Jisaye/GaN-Design/Design_path.md

# 设计思路

先进行开环的测试，后根据需要加入ADC转接板（SMA连接）进行闭环测试

开环测试思路

# 结构设计

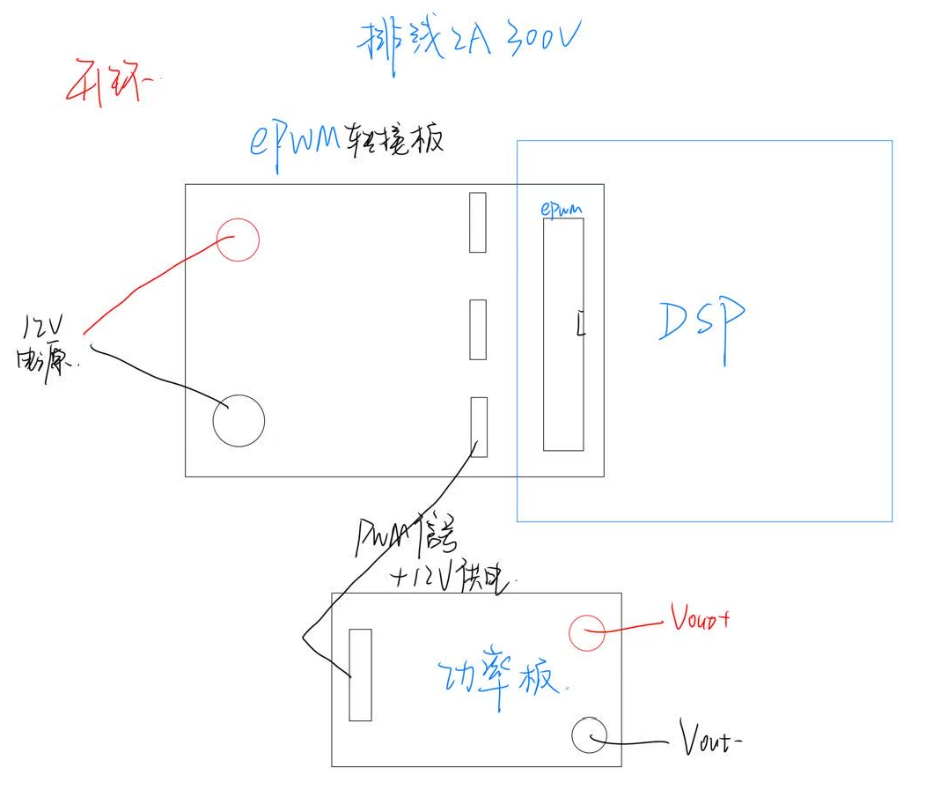
[picture p8: attachments/image-20251018164756367.png]


所以就分为EPWM转接板和主功率板两部分硬件进行设计

主功率板：

1.供电模块 2.缓冲电路 3.隔离稳压电路 4.栅极驱动电路 5.主功率桥

EPWM转接板（4层板，电源信号隔离）：

1.12V供电端口 2.三个排针连接主功率板 3.20pin排母连接EPWM模块

# 原理图设计

## 供电电路设计

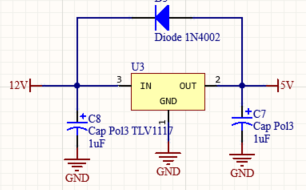
[picture p9: attachments/image-20251024210929914.png]


主要采用TLV1117芯片进行稳压，输入端口通过排插输入12V的直流电压，经过稳压后得到5V电压，用于施密特触发器芯片供电以及栅极驱动芯片的供电，设计二极管保护电路，防止12V与5V电源短接。

## 缓冲电路设计

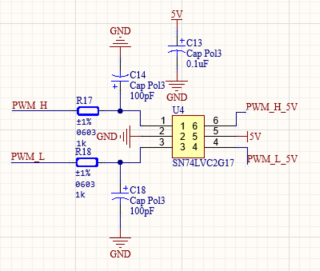
[picture p10: attachments/image-20251024211805117.png]


主要采用SN74LVC2G17 双施密特触发缓冲器，对高低端驱动的PWM进行缓冲与整形，提升信号的驱动能力和抗干扰能力，使得PWM能输出更稳定的5V电平信号，确保PWM信号在传输和处理过程中保持良好的波形质量。

## 隔离稳压电路设计

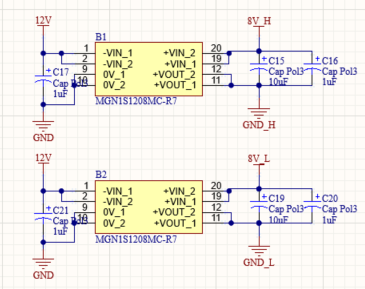
[picture p11: attachments/image-20251024212335833.png]


主要采用MGNS11208M (R-7) 芯片，用于将12V的输入电压转换为8V的输出，分高低两侧，这是为了给GaN增强型Mos的栅极驱动电路**提供单独的上拉**，需要8V的独立电源，故需要对8V电源进行隔离，分高低两侧。

## 栅极驱动电路设计

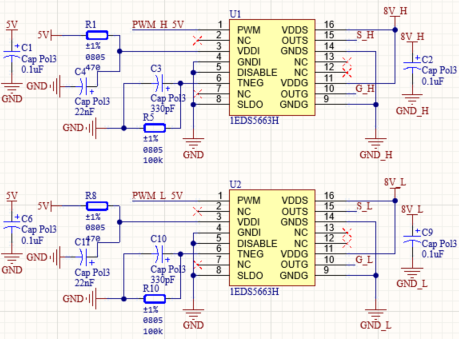
[picture p12: attachments/image-20251024213008706.png]


主要采用1EDS5663H栅极驱动芯片，用于驱动功率桥，实现对PWM信号的功率放大，输出高驱动能力的控制信号。特别注意这里的VDDI引脚输入位5V经过470Ω的电阻分压输入，根据数据手册分析，VDDI引脚通常输入3.3V电压，这里可能是考虑到5VPWM信号的注入（PWM/DISABLE引脚允许最大输入电压为6.5V）和G/S双端输出的高功率PWM信号，3.3V的供电不足以驱动。

OUTG连接GaN MOS栅极，OUTS连接GaN MOS源极，PWM引脚选通OUTG/OUTS。

## 主功率桥设计

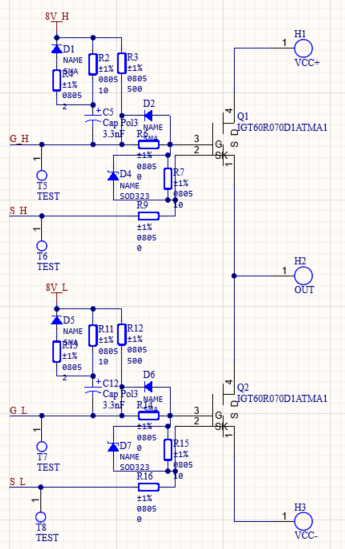
[picture p13: attachments/image-20251024213826315.png]


主要采用IGT60R070D1ATMA1增强型Mos作为主功率桥，实现对大功率负载的开关控制，通过 G_H、S_H 和 G_L、S_L 输入的驱动信号，控制 Q1、Q2 的导通与关断，从而在 OUT 端实现功率输出。IGT60R070D1ATMA1 是高压功率 MOS 管，用于承载大电流、高电压的功率传输。该增强型Mos必须运行在5~6.5V的栅极驱动下。

由二极管（D1-D4、D5、D6）、电阻（R2-R4、R7、R11-R13、R16 等）、电容（C2、C12）组成，起到信号驱动、电压钳位、过压保护等作用，确保 MOS 管稳定可靠工作。注意设计齐纳二极管对GS端进行稳压，但是也要尽量避免齐纳二极管产生的振铃现象导致驱动Mos的电压过冲而击穿。为减小齐纳二极管产生的振铃或减小环路电感请看Readme手册。

## RC吸收电路设计

主要避免电压过冲击穿Mos管。降压式缓冲电路

RC snubber通常放置在开关节点和GND之间

当时，振铃电压的振幅最低。

同时Csnub越大，同样的阻尼电阻对振铃抑制效果越好，但是达到一定程度大小以后，电容的增加给振铃抑制的效果并不显著，并且Csnub越大，对应电路的损耗会越大，效率会越差。

损耗主要包括两个方面：1.snubber电阻上的损耗，正比于电容容值。2.Mos开关损耗

因此需要在控制功耗和抑制振铃之间找到较好的平衡。



Vsw_peak为振铃峰值，fsw为开关频率

**实用快捷的snubber设计方法：**

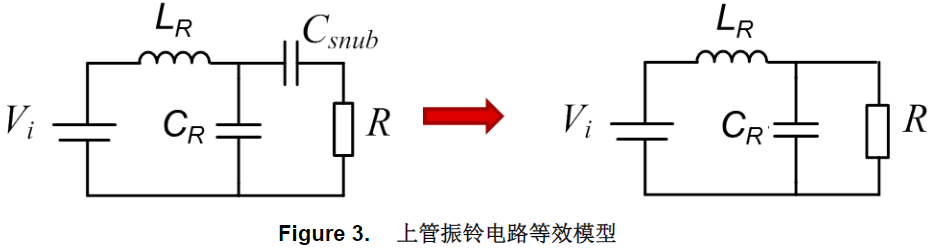
[picture p14: attachments/image-20251025142340731.png]
第一步：确定LR和CR

测量初始振铃频率：



在snubber要放置的位置上，放置一个Cadd，也就是在R的位置放一个电容，可以测得新的振铃频率表达式：



解得：

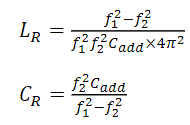
[picture p15: attachments/image-20251025142719294.png]


第二步：选取合适的R值，使得R值近似于

注意电阻的封装要考虑散热，使得电阻功率等级大于电阻上的损耗，根据电阻损耗表达式进行计算。

第三步：选择合适的电容值Csnub



以该式为起点，根据损耗情况和振幅抑制效果，进行进一步的调整——增大电容抑制振幅，减小电容提高效率。

下面是几种设计样例：

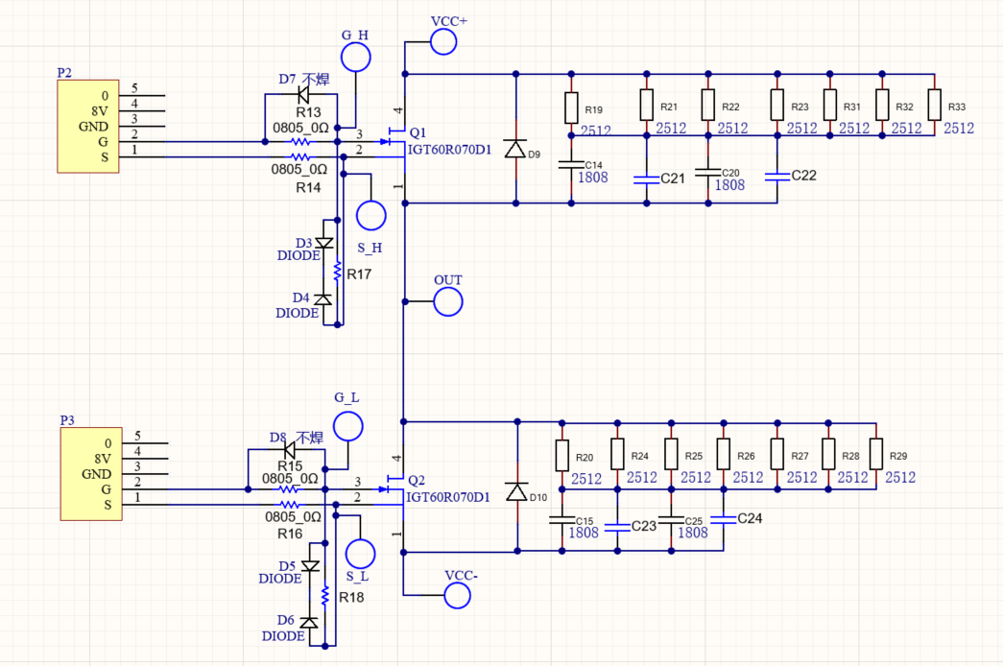
[picture p16: attachments/image-20251024220959552.png]


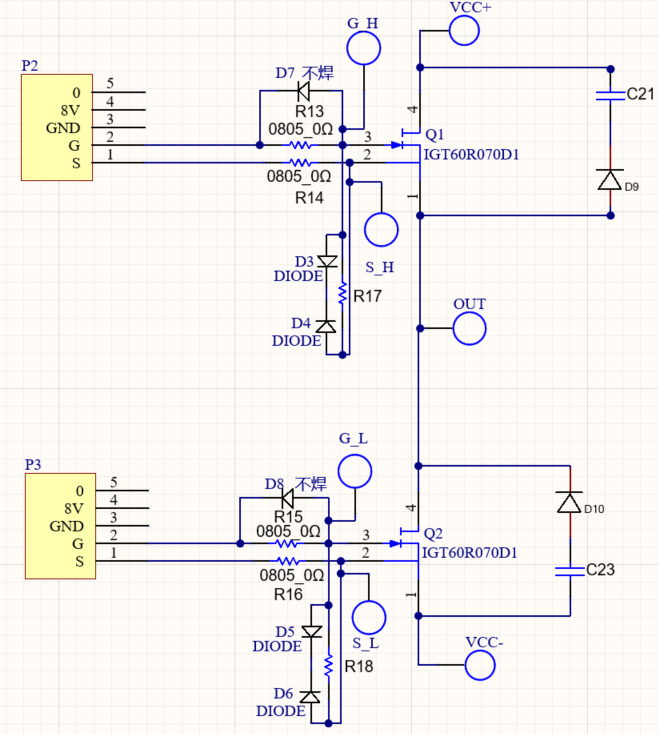
[picture p17: attachments/image-20251024221012875.png]


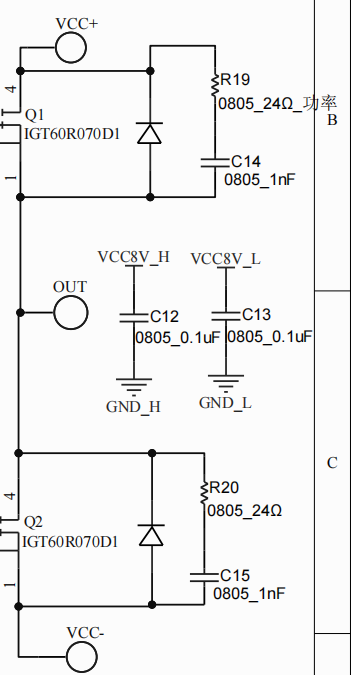
[picture p18: attachments/image-20251024221059903.png]


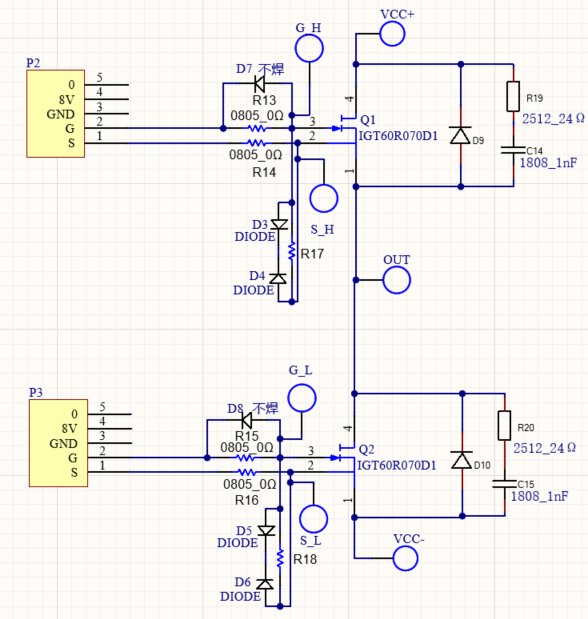
[picture p19: attachments/image-20251024221135009.png]


# PCB设计

单个半桥驱动模块：

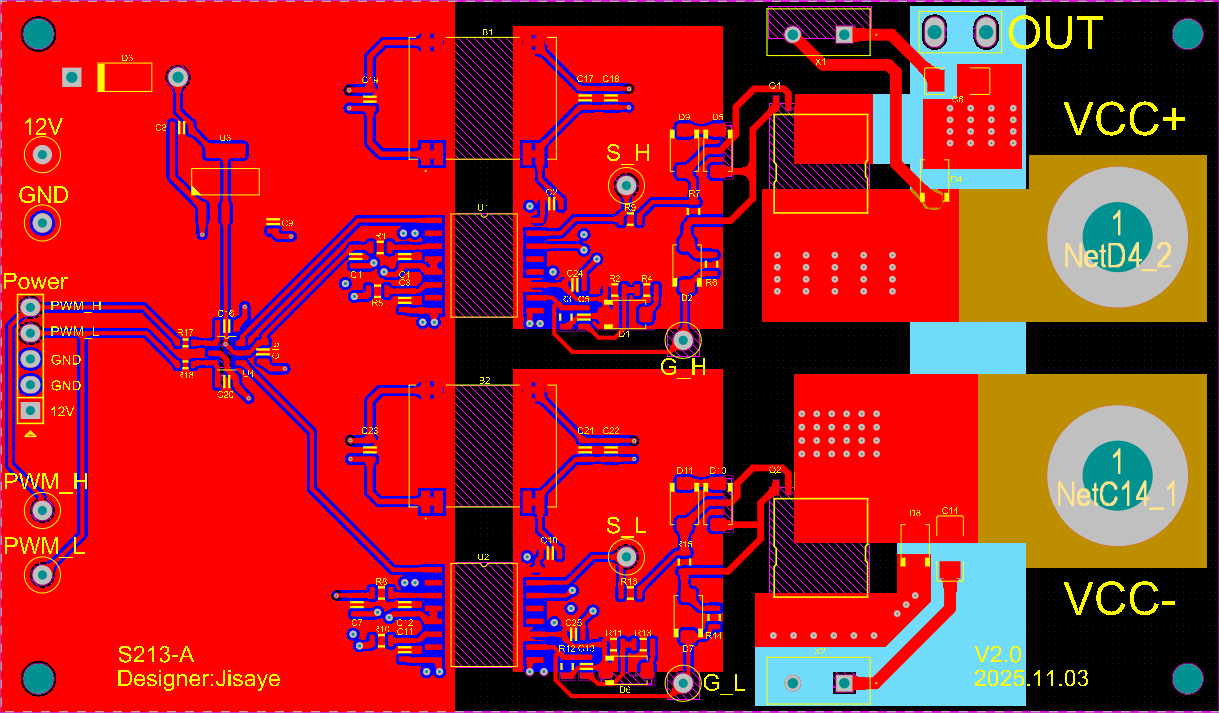
[picture p20: attachments/image-20251115161653602.png]


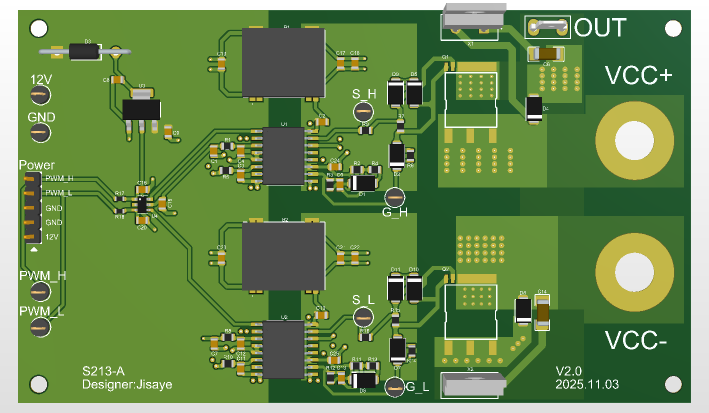
[picture p21: attachments/92a81938bc1906c612e0f3bcebc02985.png]
92a81938bc1906c612e0f3bcebc02985


扩展板：

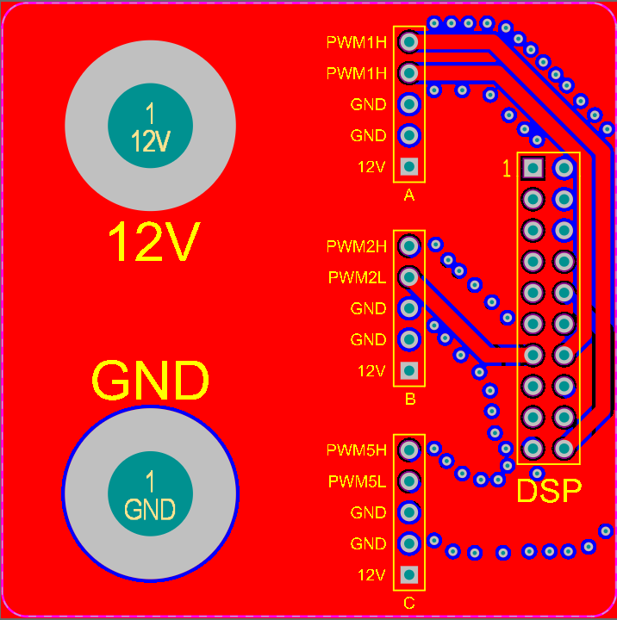
[picture p22: attachments/image-20251115161814362.png]


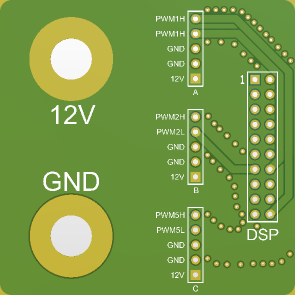
[picture p23: attachments/Adapter_board.png]
Adapter_board


注意铺铜和过孔扇出问题（散热）：

1.在电路板另一面放置一个铜平面也能让热阻降低10%~20%，这个“背面的”铜平面甚至不必有电气连接，或只是普通的地平面。

2.导热过孔（孔洞直径为0.3~0.33mm），给定面积内，过孔间距（即圆心之间的距离）一般为1~1.2mm。

3.过孔网格可非常接近功率元器件，可围绕在其周边，甚至可在其裸焊盘散热封装之下。

# V1.0设计问题

1.隔离稳压电路设计错误

2.Mos管下管没有在器件底部加过孔散热

3.齐纳二极管的设计改用两个肖特基二极管反向串联

# V2.0测试问题

1.半桥测试Vgs时：

deaa3353df4ef1a6beea733b5e29f5c4

出现类似振铃现象，有尖峰电压

把0Ω电阻反并联的二极管卸下来再进行测试，发现依然有尖峰电压

将栅源之间的钳位二极管卸下来进行测试，发现依然有尖峰电压

# 软件程序设计

启用EPWM1、2、5共3组PWM

死区时间设置为双边100ns：

EPwm1Regs.DBCTL.all=0xb;      // EPWMxB is inverted

EPwm1Regs.DBRED=15;         //15×6.66ns=99.9ns 

EPwm1Regs.DBFED=15;         

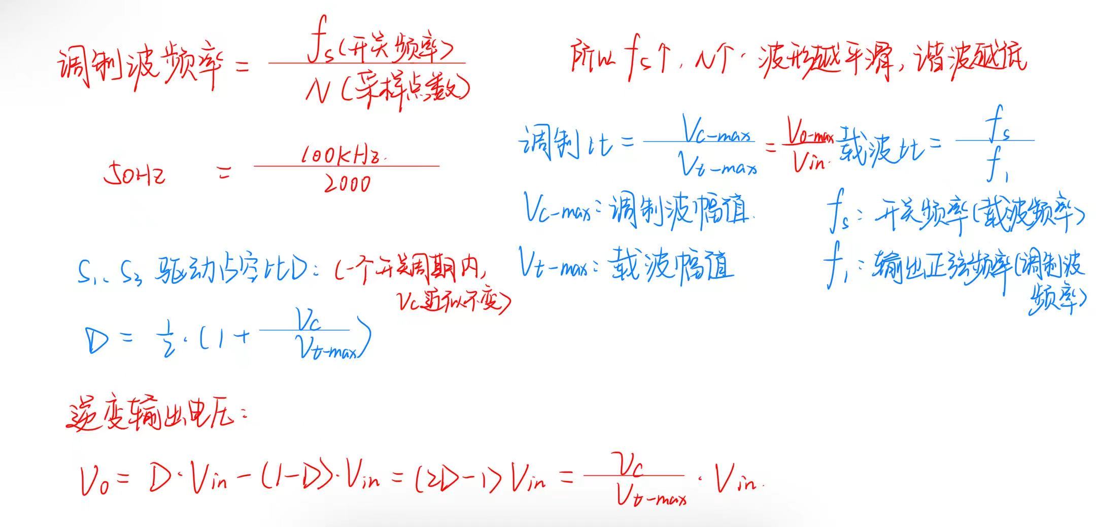
[picture p24: attachments/b4272520a81ae593bc5b931ae7a225b3.jpg]
b4272520a81ae593bc5b931ae7a225b3


所以在该处若要设置输出交流频率为50Hz，则调制波频率也为50Hz，设置对应开关频率为100kHz，则计算得到的采样点数应为2000个

# LC滤波器设计

GaN逆变器设计 1

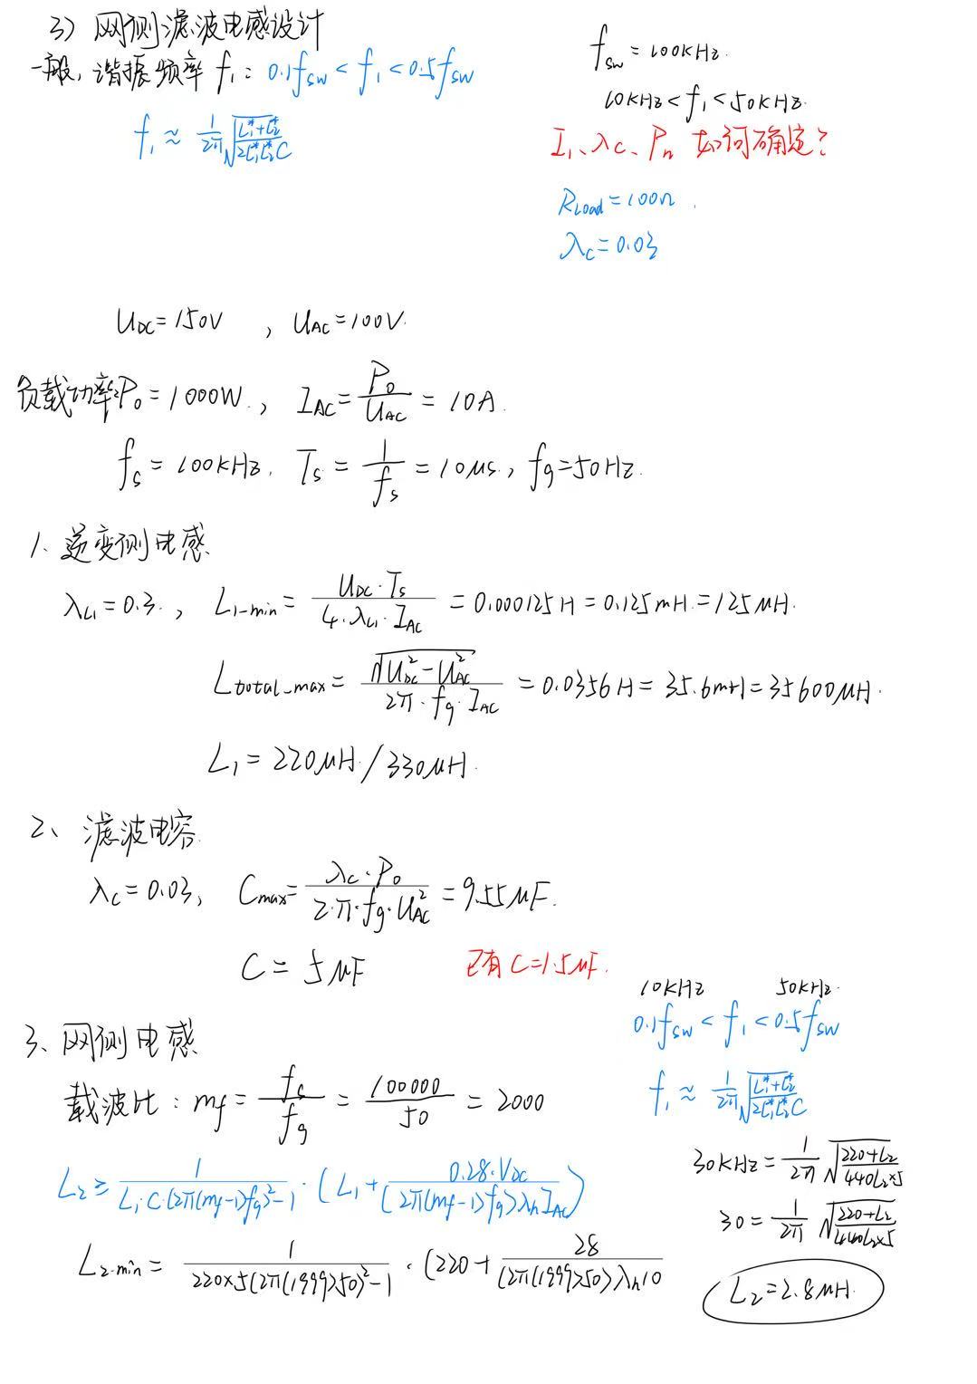
[picture p25: attachments/b05dca6a37b60201d5a14648d1980b6b.jpg]
b05dca6a37b60201d5a14648d1980b6b
