Jisaye/GaN-Design/attachments/0e99363a695cc59ffe74b46b7de625e9.jpg

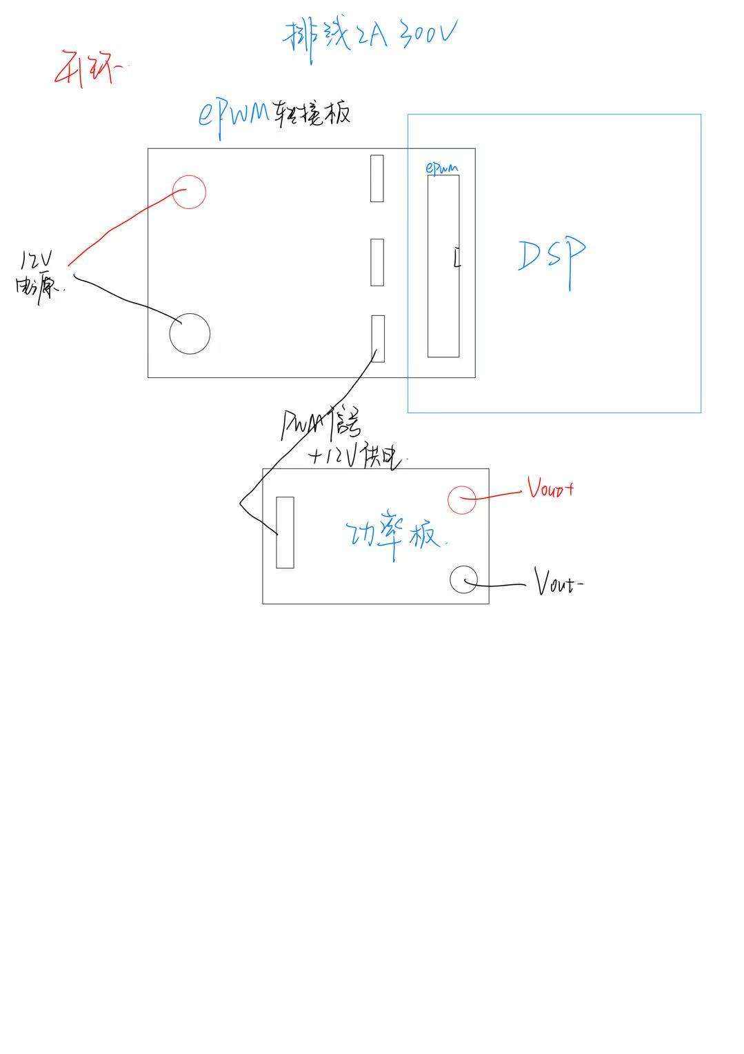
attachments/0e99363a695cc59ffe74b46b7de625e9.jpg
