Jisaye/GaN-Design/attachments/c5bc501b1a00698f0544eda4c9d6d939.jpg

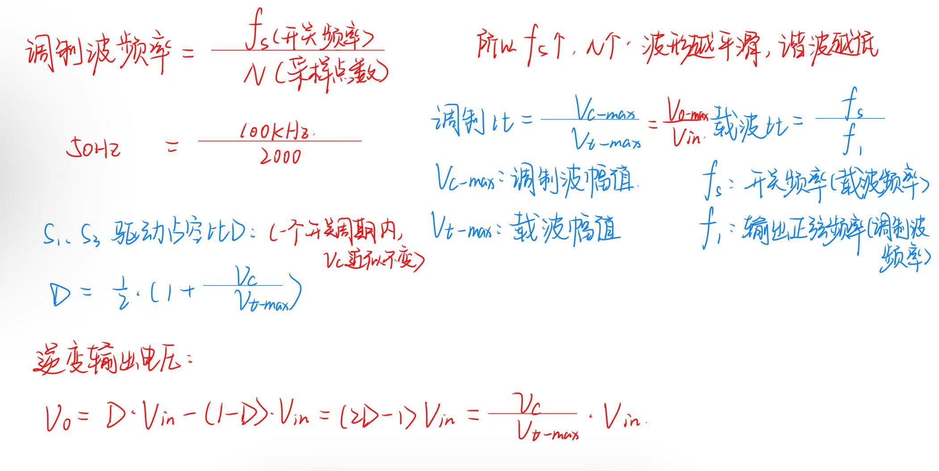
attachments/c5bc501b1a00698f0544eda4c9d6d939.jpg
