Jisaye/GaN-Design/attachments/image-20251025164017639.png

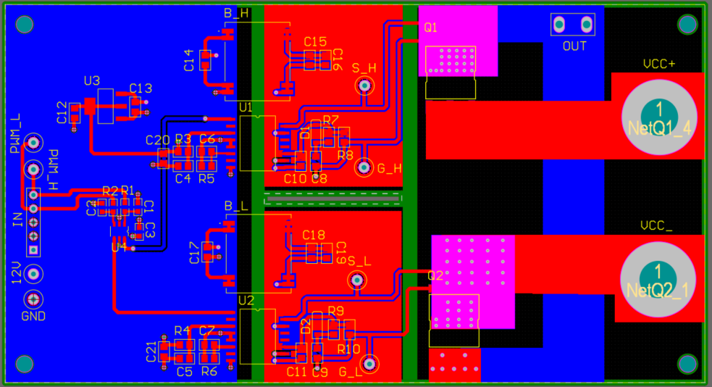
attachments/image-20251025164017639.png
