Jisaye/GaN-Design/Hardware/Adapter_board/Project Outputs for Adapter_board/Adapter_board.xlsx

Comment | Description | Designator | Footprint
12V |  | H1 | HOLE
GND |  | H2 | HOLE
Phase_A | Header, 5-Pin | P1 | HDR1X5
DSP | Header, 10-Pin, Dual row | P2 | HDR2X10
Phase_B | Header, 5-Pin | P3 | HDR1X5
Phase_C | Header, 5-Pin | P4 | HDR1X5
