Jisaye/GaN-Design/Hardware/Component/1808HC331KAT1A/3D/1808HC331KAT1A.stp

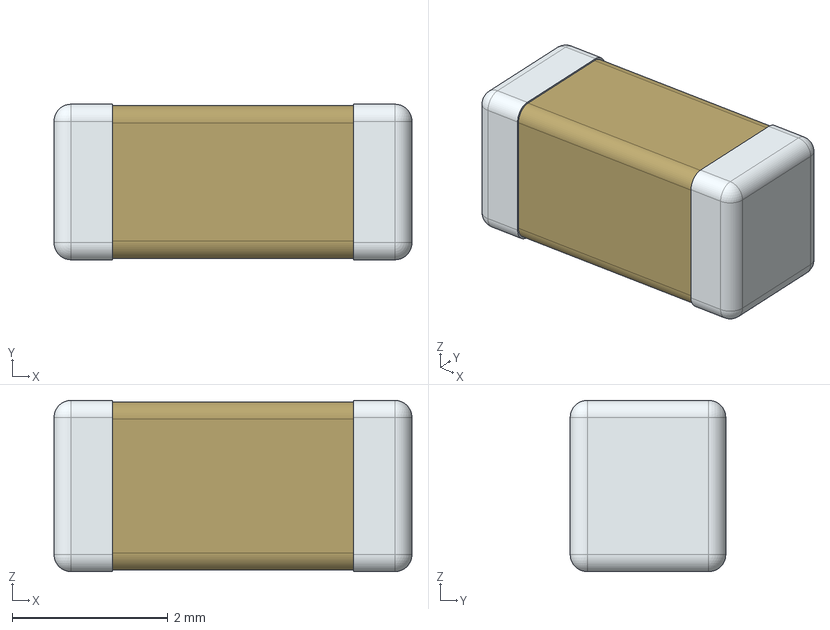
[picture p29: CAD file, 2025-10-26]
Hardware/Component/1808HC331KAT1A/3D/1808HC331KAT1A.stp
4.60 x 2.00 x 2.20 mm
