Jisaye/GaN-Design/Hardware/Component/1EDS5663HXUMA1/3D/1EDS5663HXUMA1.stp

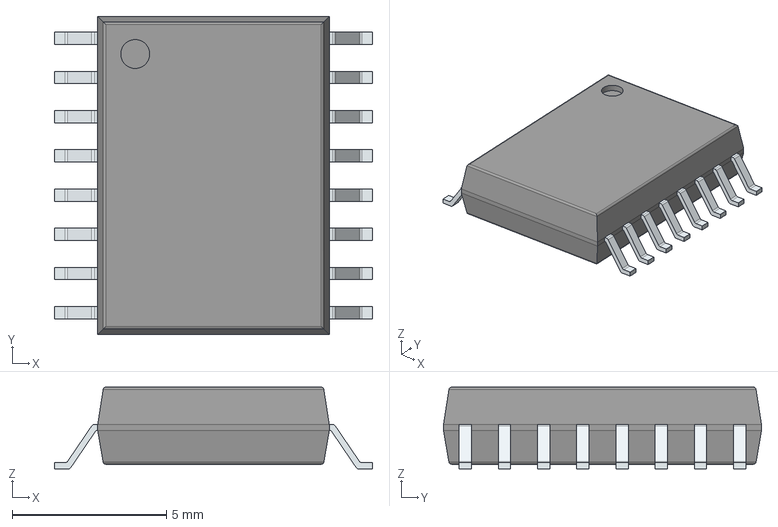
[picture p30: CAD file, 2025-10-26]
Hardware/Component/1EDS5663HXUMA1/3D/1EDS5663HXUMA1.stp
10.3 x 10.3 x 2.65 mm
PinsArrayLR
