Jisaye/GaN-Design/Hardware/Component/1N4002/3D/1N4002..stp

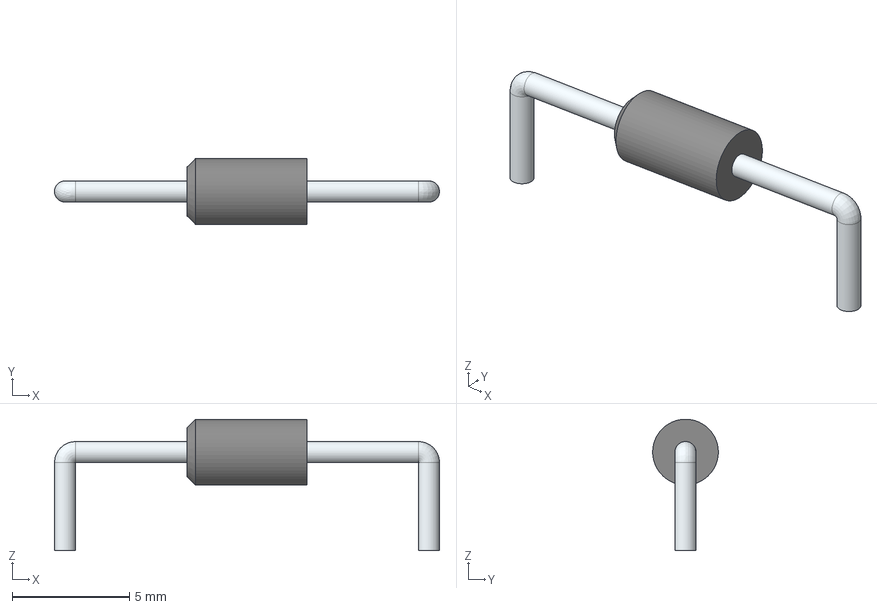
[picture p31: CAD file, 2025-10-26]
Hardware/Component/1N4002/3D/1N4002..stp
16.4 x 2.80 x 5.60 mm
