Jisaye/GaN-Design/Hardware/Component/IGT60R070D1ATMA1/3D/IGT60R070D1ATMA1.stp

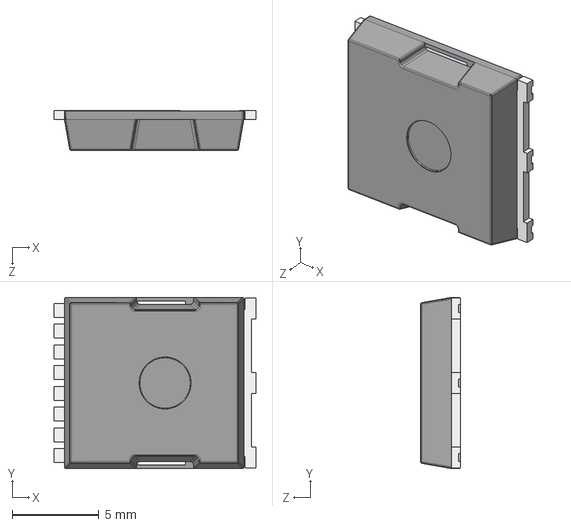
[picture p32: CAD file, 2025-10-26]
Hardware/Component/IGT60R070D1ATMA1/3D/IGT60R070D1ATMA1.stp
11.7 x 9.90 x 2.30 mm
