Jisaye/GaN-Design/Hardware/Component/MGN1S1208MC-R7/3D/MGN1S1208MC-R7.stp

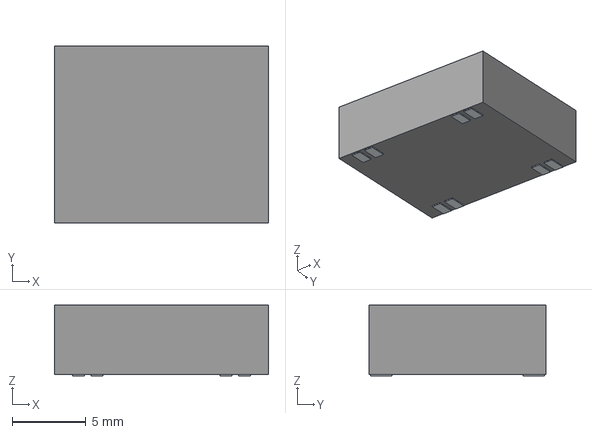
[picture p33: CAD file, 2025-10-26]
Hardware/Component/MGN1S1208MC-R7/3D/MGN1S1208MC-R7.stp
14.5 x 12.0 x 4.80 mm
Pins
