Jisaye/GaN-Design/Hardware/Component/TR35JBX50L0/3D/TR35JBX50L0.stp

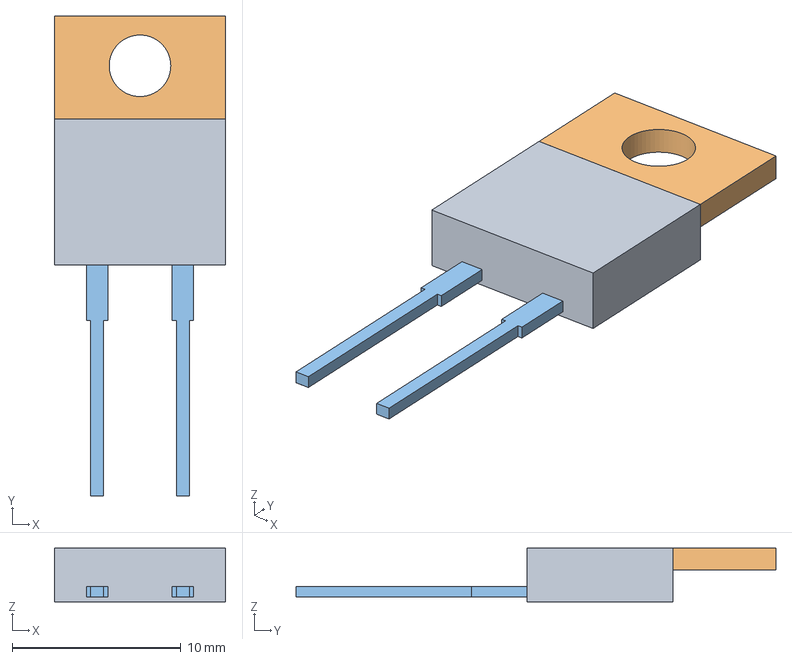
[picture p34: CAD file, 2025-10-25]
Hardware/Component/TR35JBX50L0/3D/TR35JBX50L0.stp
10.2 x 28.4 x 3.18 mm
