Jisaye/GaN-Design/(list of files, cad)

Other CAD files:
Software/PWM_Drive_Test/Release/source/DSP2833x_GlobalVariableDefs.obj
Software/SPWM_Drive_Test/Release/source/DSP2833x_DefaultIsr.obj
Software/PWM_Drive_Test/Release/source/Example_EPwmSetup.obj
Software/SPWM_Drive_Test/Release/source/Gpio.obj
Software/PWM_Drive_Test/Release/source/Gpio.obj
Software/SPWM_Drive_Test/Release/source/DSP2833x_CodeStartBranch.obj
Software/PWM_Drive_Test/Release/source/DSP2833x_PieCtrl.obj
Software/SPWM_Drive_Test/Release/source/DSP2833x_EPwm.obj
Software/PWM_Drive_Test/Release/source/DSP2833x_SysCtrl.obj
Software/SPWM_Drive_Test/Release/source/Example_EPwmSetup.obj
Software/PWM_Drive_Test/Release/source/DSP2833x_EPwm.obj
Software/SPWM_Drive_Test/Release/source/DSP2833x_PieVect.obj
Software/PWM_Drive_Test/Release/source/DSP2833x_PieVect.obj
Software/SPWM_Drive_Test/Release/source/DSP2833x_PieCtrl.obj
Software/PWM_Drive_Test/Release/source/DSP2833x_usDelay.obj
Software/SPWM_Drive_Test/Release/source/DSP2833x_SysCtrl.obj
Software/PWM_Drive_Test/Release/source/DSP2833x_CodeStartBranch.obj
Software/SPWM_Drive_Test/Release/source/DSP2833x_usDelay.obj
Software/PWM_Drive_Test/Release/source/DSP2833x_DefaultIsr.obj
Software/SPWM_Drive_Test/Release/source/DSP2833x_GlobalVariableDefs.obj
Hardware/Component/1808HC331KAT1A/Allegro/capc4620x220n.psm
Hardware/Component/1808HC331KAT1A/DEHDL/1808hc331kat1a/chips/chips.prt
Hardware/Component/1EDS5663HXUMA1/Allegro/soic127p1030x265-16n.psm
Hardware/Component/1EDS5663HXUMA1/DEHDL/1eds5663hxuma1/chips/chips.prt
Hardware/Component/1N4002/Allegro/dioad1550w90l510d260.psm
Hardware/Component/1N4002/DEHDL/1n4002/chips/chips.prt
Hardware/Component/IGT60R070D1ATMA1/Allegro/igt60r070d1atma1.psm
Hardware/Component/IGT60R070D1ATMA1/DEHDL/igt60r070d1atma1/chips/chips.prt
Hardware/Component/MGN1S1208MC-R7/Allegro/mgn1s1208mcr7.psm
Hardware/Component/MGN1S1208MC-R7/DEHDL/mgn1s1208mc_r7/chips/chips.prt
Hardware/Component/TR35JBX50L0/Allegro/tr35jbx50l0.psm
Hardware/Component/TR35JBX50L0/DEHDL/tr35jbx50l0/chips/chips.prt
