Jisaye/GaN-Design/参考文档/GaN原理图.pdf

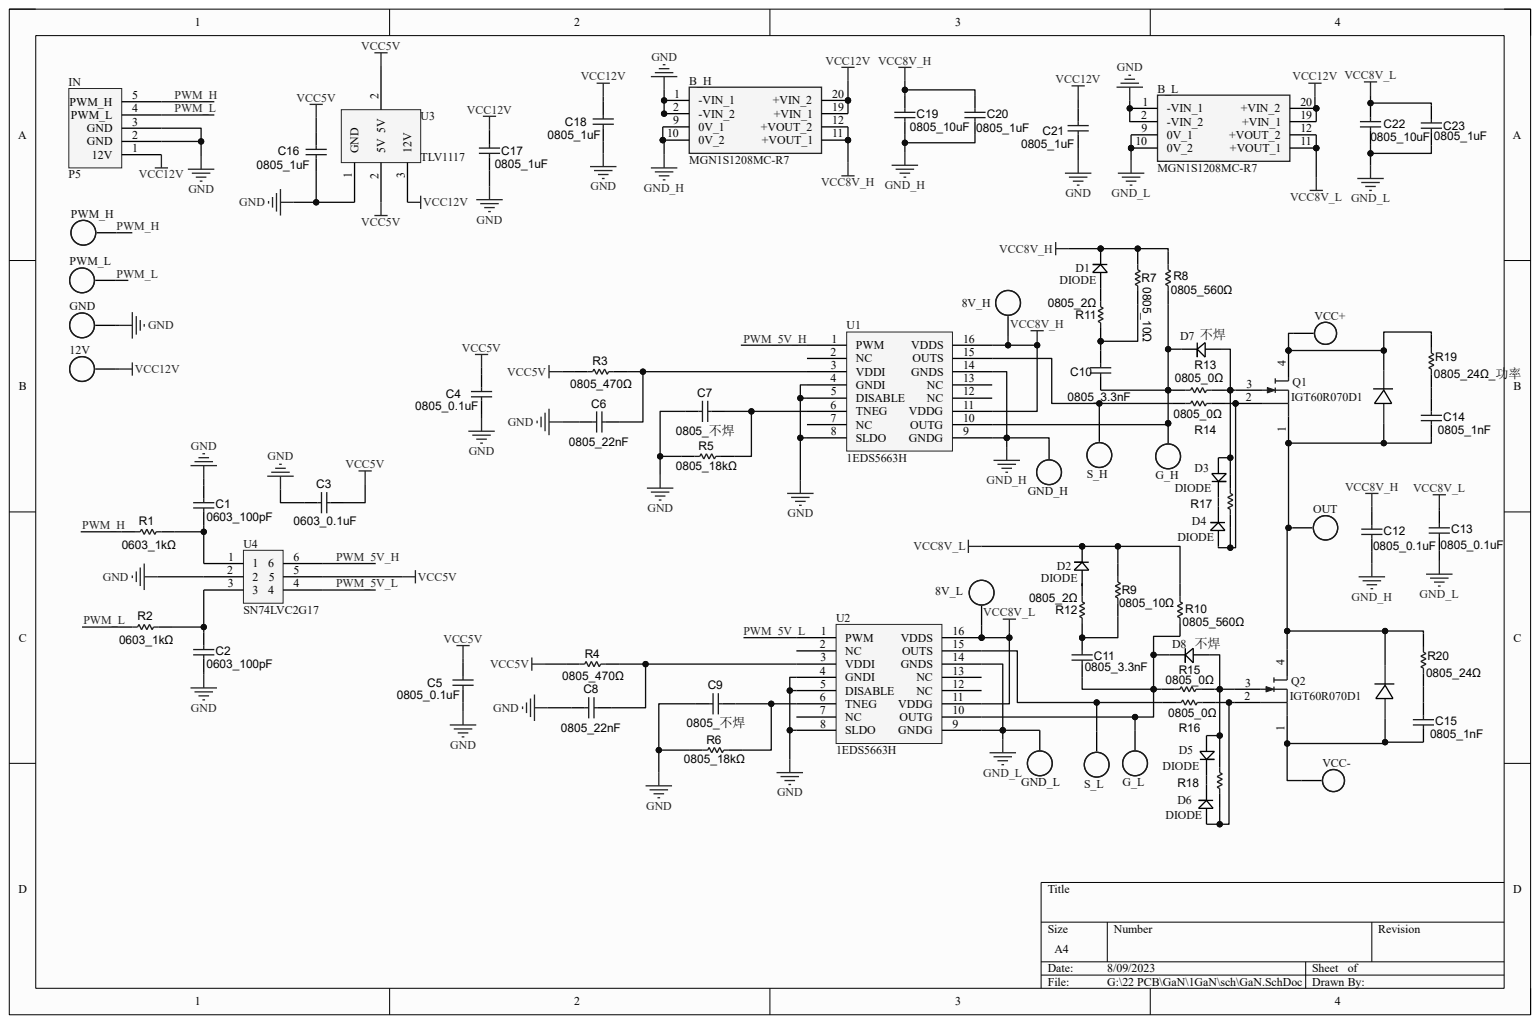
[picture p36: page 1]
