Jisaye/GaN-Design/(list of files, drawings)

Other design files:
Hardware/Adapter_board/Adapter_board .SchDoc
Hardware/Adapter_board/Adapter_board.PcbDoc
Hardware/Adapter_board/Adapter_board.PrjPcb
Hardware/Component/1EDS5663HXUMA1/Altium/1EDS5663HXUMA1.SchLib
Hardware/Component/1EDS5663HXUMA1/Altium/SOIC127P1030X265-16N.PcbLib
Hardware/Component/1N4002/Altium/1N4002..SchLib
Hardware/Component/1N4002/Altium/DIOAD1550W90L510D260.PcbLib
Hardware/Component/1808HC331KAT1A/Altium/1808HC331KAT1A.SchLib
Hardware/Component/1808HC331KAT1A/Altium/CAPC4620X220N.PcbLib
Hardware/Component/IGT60R070D1ATMA1/Altium/IGT60R070D1ATMA1.PcbLib
Hardware/Component/IGT60R070D1ATMA1/Altium/IGT60R070D1ATMA1.SchLib
Hardware/Component/MGN1S1208MC-R7/Altium/MGN1S1208MC-R7.SchLib
Hardware/Component/MGN1S1208MC-R7/Altium/MGN1S1208MCR7.PcbLib
Hardware/Component/TR35JBX50L0/Altium/TR35JBX50L0.PcbLib
Hardware/Component/TR35JBX50L0/Altium/TR35JBX50L0.SchLib
Hardware/GaN_Single_Bridge/GaN_Single_Bridge.PcbDoc
Hardware/GaN_Single_Bridge/GaN_Single_Bridge.PrjPcb
Hardware/GaN_Single_Bridge/GaN_Single_Bridge.SchDoc
Hardware/LCL_Filter/LCL_Filter.PrjPcb
Hardware/LCL_Filter/LCL_Filter.SchDoc
