Jisaye/GaN-Design/(commit log)

2025-09-29 设计参考文档
2025-09-29 更新 README.md 文件
2025-09-29 数据手册更新
2025-09-29 readme更新
2025-09-29 删除子项目 GaN-Design
2025-10-15 updata:readme and ADschtemplet
    [GaN_Single_Bridge.PrjPcb, GaN_Single_Bridge.SchDoc]
2025-10-18 update:Hardware_sch and Design_path
    [GaN_Single_Bridge.PrjPcb]
2025-10-19 update: AD sch finish
    [Schlib1.SchLib]
2025-10-19 update: AD PCB and AD shortcuts
    [GaN_Single_Bridge.PcbDoc, GaN_Single_Bridge.PrjPcb, Schlib1.SchLib]
2025-10-25 update: RC filter and PCB layout
    [EDI2CAP.CFG, GaN_Single_Bridge.PcbDoc, GaN_Single_Bridge.PrjPcb, TR35JBX50L0.PcbLib, TR35JBX50L0.SchLib, TR35JBX50L0.stp, chips.prt, tr35jbx50l0.psm]
2025-10-26 update : GaN_Singal_Bridge done!
    [1808HC331KAT1A.SchLib, 1808HC331KAT1A.stp, 1EDS5663HXUMA1.SchLib, 1EDS5663HXUMA1.stp, 1N4002..SchLib, 1N4002..stp, CAPC4620X220N.PcbLib, DIOAD1550W90L510D260.PcbLib]
2025-10-27 update: hardware_main done!
    [GaN_Single_Bridge.PcbDoc, GaN_Single_Bridge.PrjPcb]
2025-10-29 update: Adapter_board done!
    [Adapter_board .SchDoc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]
2025-11-03 update: GaN_Single_Bridge V2.0 done!
    [Adapter_board.PcbDoc, Adapter_board.PrjPcb, Adapter_board.xlsx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]
2025-11-18 update: singal_phase test and LCL_Filter design
    [Adapter_board.PcbDoc, Adapter_board.PrjPcb, DSP2833x_CodeStartBranch.obj, DSP2833x_DefaultIsr.obj, DSP2833x_EPwm.obj, DSP2833x_GlobalVariableDefs.obj, DSP2833x_PieCtrl.obj, DSP2833x_PieVect.obj]
